automote/thingBot-LoRa/v1.1/REPORTS/thingBot-LoRa_v1P1_report.txt

Plot file 'P:\PCB Design\thingBot-LoRa\v1.1\GERBERS\thingBot-LoRa_v1P1-F.Cu.gbr' created.
Plot file 'P:\PCB Design\thingBot-LoRa\v1.1\GERBERS\thingBot-LoRa_v1P1-B.Cu.gbr' created.
Plot file 'P:\PCB Design\thingBot-LoRa\v1.1\GERBERS\thingBot-LoRa_v1P1-B.Paste.gbr' created.
Plot file 'P:\PCB Design\thingBot-LoRa\v1.1\GERBERS\thingBot-LoRa_v1P1-F.Paste.gbr' created.
Plot file 'P:\PCB Design\thingBot-LoRa\v1.1\GERBERS\thingBot-LoRa_v1P1-B.SilkS.gbr' created.
Plot file 'P:\PCB Design\thingBot-LoRa\v1.1\GERBERS\thingBot-LoRa_v1P1-F.SilkS.gbr' created.
Plot file 'P:\PCB Design\thingBot-LoRa\v1.1\GERBERS\thingBot-LoRa_v1P1-B.Mask.gbr' created.
Plot file 'P:\PCB Design\thingBot-LoRa\v1.1\GERBERS\thingBot-LoRa_v1P1-F.Mask.gbr' created.
Plot file 'P:\PCB Design\thingBot-LoRa\v1.1\GERBERS\thingBot-LoRa_v1P1-Dwgs.User.gbr' created.
Plot file 'P:\PCB Design\thingBot-LoRa\v1.1\GERBERS\thingBot-LoRa_v1P1-Edge.Cuts.gbr' created.
Plot file 'P:\PCB Design\thingBot-LoRa\v1.1\GERBERS\thingBot-LoRa_v1P1-Margin.gbr' created.
Plot file 'P:\PCB Design\thingBot-LoRa\v1.1\GERBERS\thingBot-LoRa_v1P1-B.Fab.gbr' created.
Plot file 'P:\PCB Design\thingBot-LoRa\v1.1\GERBERS\thingBot-LoRa_v1P1-F.Fab.gbr' created.
