automote/thingBot-LoRa/v1.1/thingBot-LoRa_v1P1.xlsx

thingBot-LoRa
BILL OF MATERIALS
Item | Quantity | Reference | Value | DESC | MFG_NAME | MPN | Package | Footprint | 1 | 100 | 500 | 1000 |  | 10 PCB | 100 PCB | 1000 PCB
1 | 1 | C1 | 15nF | CAPACITOR, CERAMIC X7R, 15nF, 50V, -10%/+10%, -55DEGC/+125DEGC, 0805, SMD | Murata | GRM219R71H153KA01D | 805 | Capacitors_SMD:C_0805_HandSoldering | 7 | 1.75 | 1.54 | 1.19 |  | 7 | 1.75 | 1.19
2 | 1 | C2 | 0.1uF | CAPACITOR, CERAMIC X7R, 0.1uF, 25V, -10%/+10%, -55DEGC/+125DEGC, 0805, SMD | Murata | GRM21BR71E104KA01L | 805 | Capacitors_SMD:C_0805_HandSoldering | 7 | 1.12 | 1.12 | 1.12 |  | 7 | 1.12 | 1.12
3 | 1 | D1 | Green POWER LED | LED, 2V, -55DEGC/+85DEGC, 0805, SMD | Lite-On | LTST-C171KGKT | 805 | LEDs:LED_0805 | 22.4 | 5.39 | 5.39 | 4.13 |  | 22.4 | 5.39 | 4.13
4 | 2 | R1 R2 | 1K | Current Sense Resistors - RESISTOR, 1K, -25%/+25% - 55DEGC/+125DEGC, 0805,SMD | Murata | BLM21AG102SN1D | 805 | Resistors_SMD:R_0805_HandSoldering | 7.7 | 2.8 | 2.8 | 2.59 |  | 15.4 | 5.6 | 5.18
5 | 1 | SW1 | RESET | TACTILE SWITCH, 50mA, 12VDC, -25dDEGC/+70DEGC, SMD | OMRON | B3U-1000P | B3U-1000P | Buttons_Switches_SMD:SW_SPST_B3U-1000P | 72.1 | 52.22 | 43.26 | 38.64 |  | 72.1 | 52.22 | 38.64
6 | 1 | U1 | EDGE_SMA | EDGE CONNECTOR, COAX RF, STRAIGHT, FEMALE, 1 PIN, SMD | Samtec | SMA-J-P-X-ST-EM1 |  | sma:EDGE_SMA_5 | 120 | 100 | 90 | 80 |  | 120 | 100 | 80
7 | 1 | U2 | RFM92/95 | Low Power Long Range Transceiver Module | ***** | ***** |  | Temp:RFM92_95_96_98 | 822.95 | 680.75 | 680.184 | 680 |  | 822.95 | 680.75 | 680
8 | 1 | U3 | XBEE_MODULE | XBee male plug | Harwin | M22-2510205 |  | Xbee:Xbee_mod | 13.3 | 6.37 | 6.37 | 5.6 |  | 13.3 | 6.37 | 5.6
9 | 1 | W1 | WIRE_ANT | wire antenna | ***** | ***** |  | Wire_Pads:SolderWirePad_single_2mmDrill | 0 | 0 | 0 | 0 |  | 0 | 0 | 0
10 | 2 | P7&p8 | Xbee_module_headers | 1x10 2mm male Header Through Hole | Harwin | M22-2510205 |  |  | 13.3 | 6.37 | 0 | 5.6 |  | 26.6 | 12.74 | 11.2
11 | 2 | R3 R4 | 0 ohm | Thin Film Resistors - SMD 0ohm 150V +/- 5% 0805, SMD | Yageo | AF0805JR-070RL | 805 | Resistors_SMD:R_0805_HandSoldering | 9.8 | 1.89 |  | 1.33 |  | 19.6 | 3.78 | 2.66
 |  |  |  |  |  |  |  |  |  |  |  |  | Total | 1126.35 | 869.72 | 829.72
