automote/thingBot-LoRa/v1.1/thingBot-LoRa_v1P1_BRD.pdf

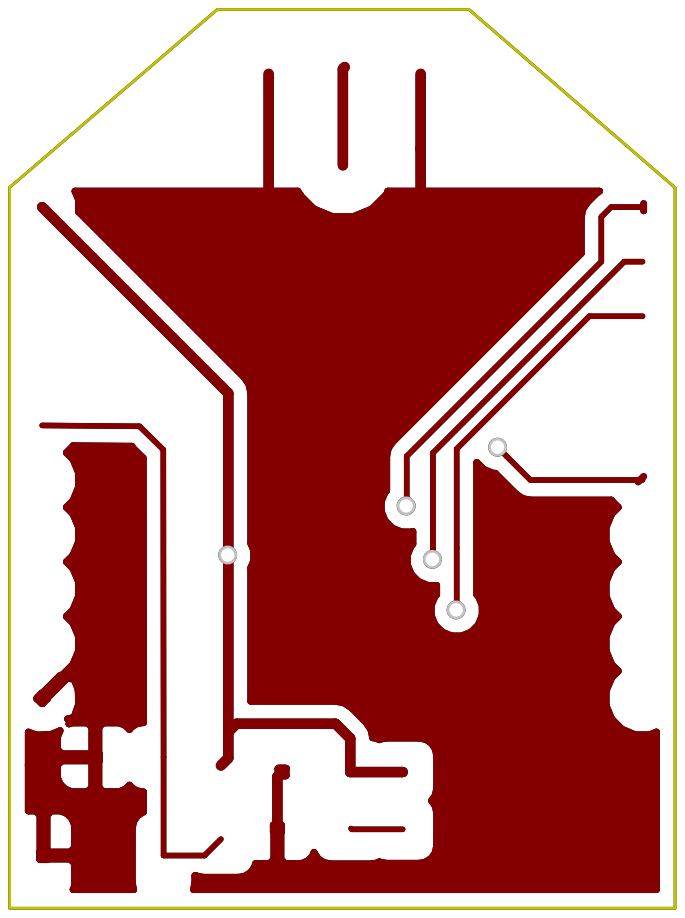
[picture p1: page 1]

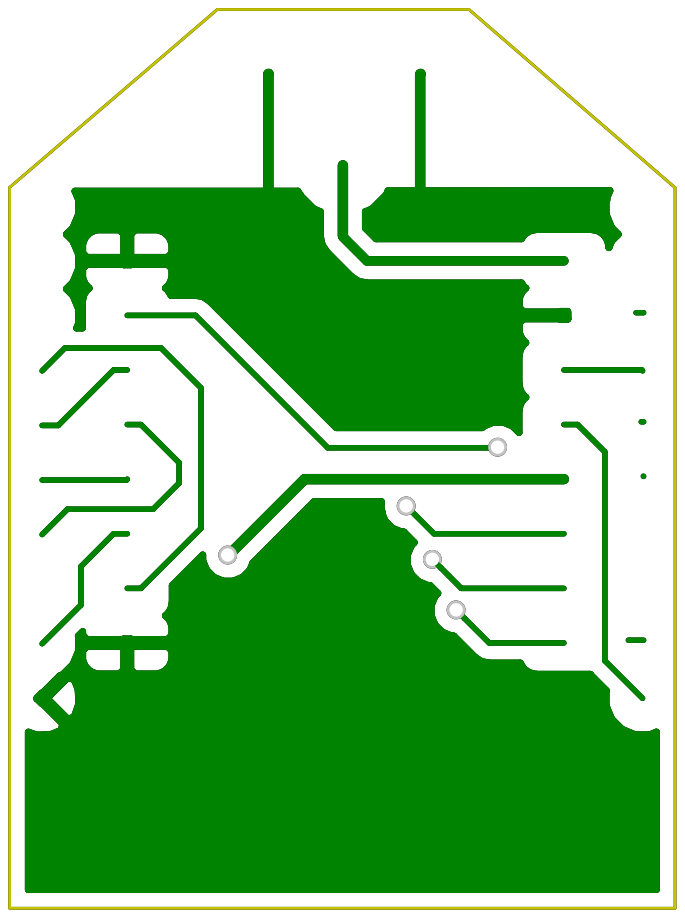
[picture p2: page 2]

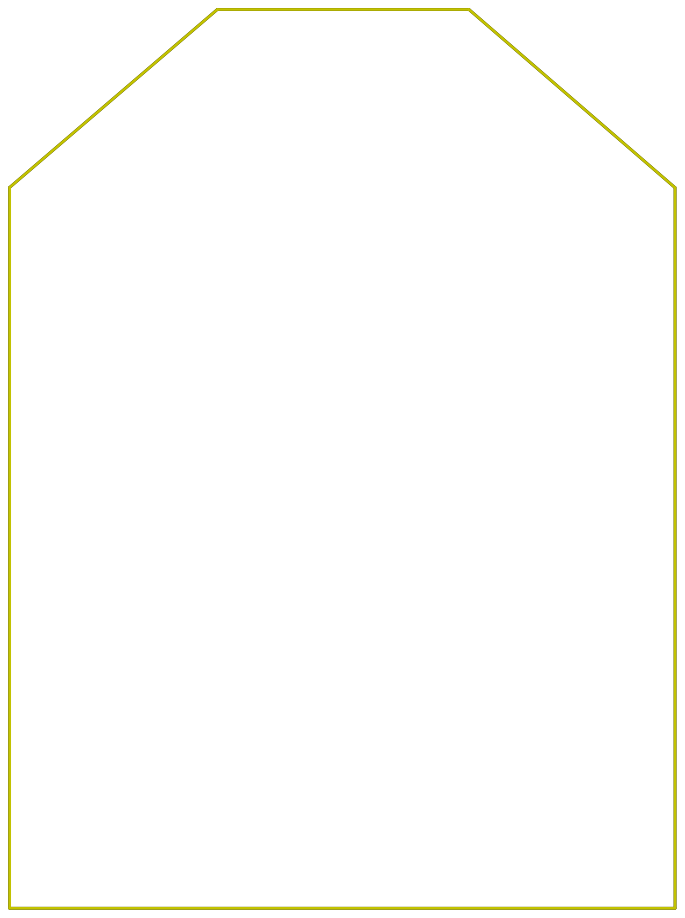
[picture p3: page 3]

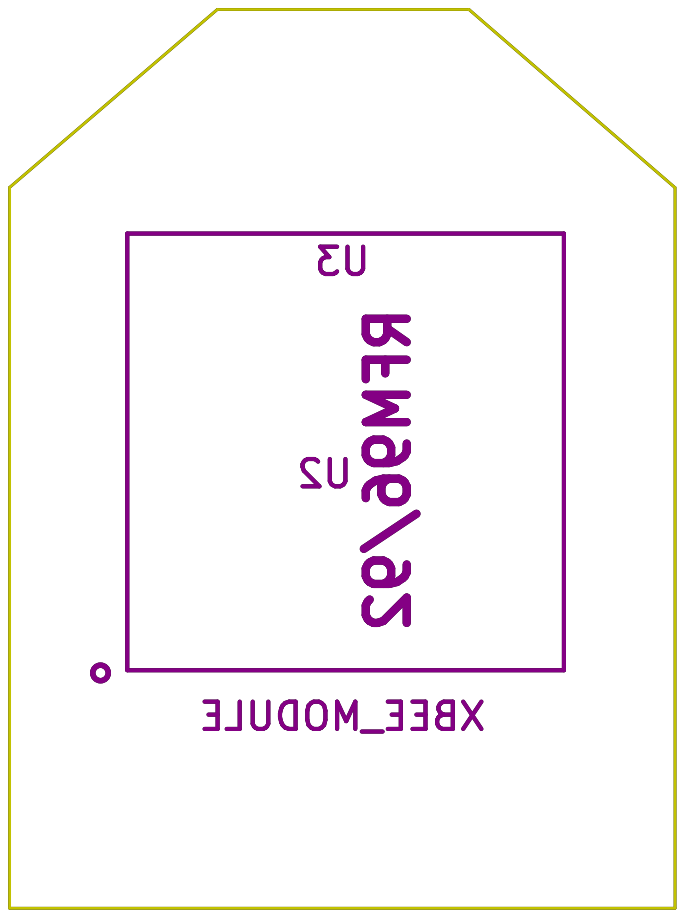
[picture p4: page 5]

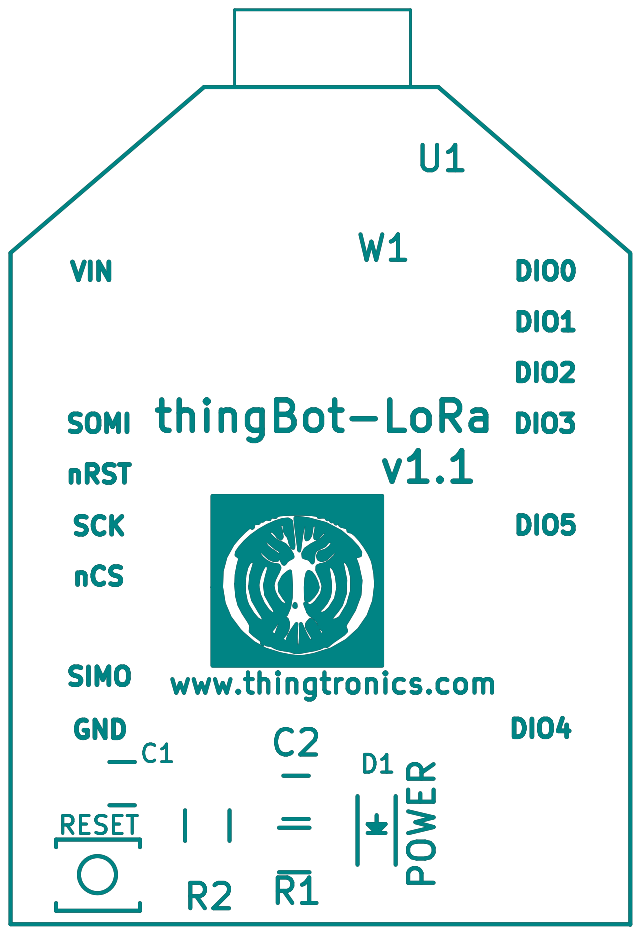
[picture p5: page 6]

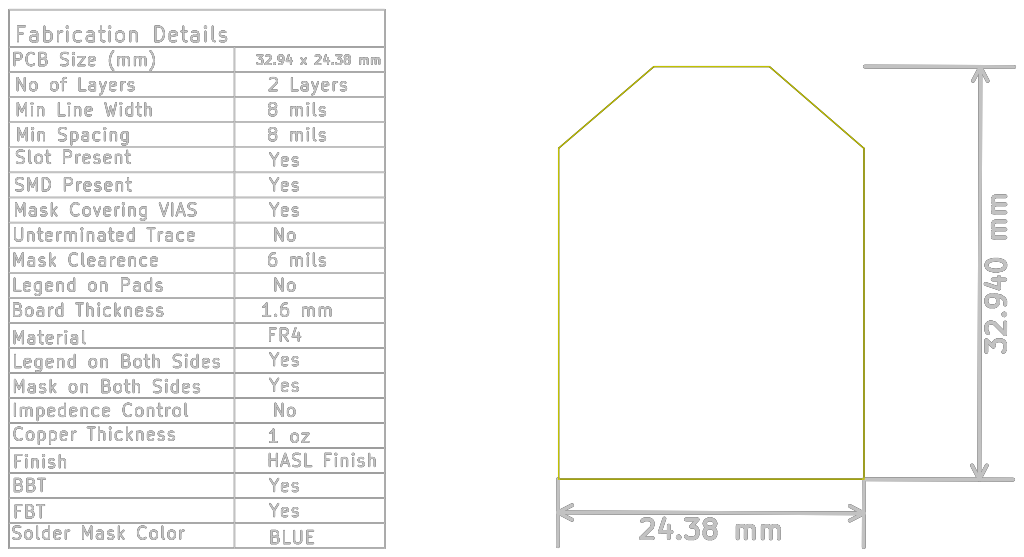
[picture p6: page 9]

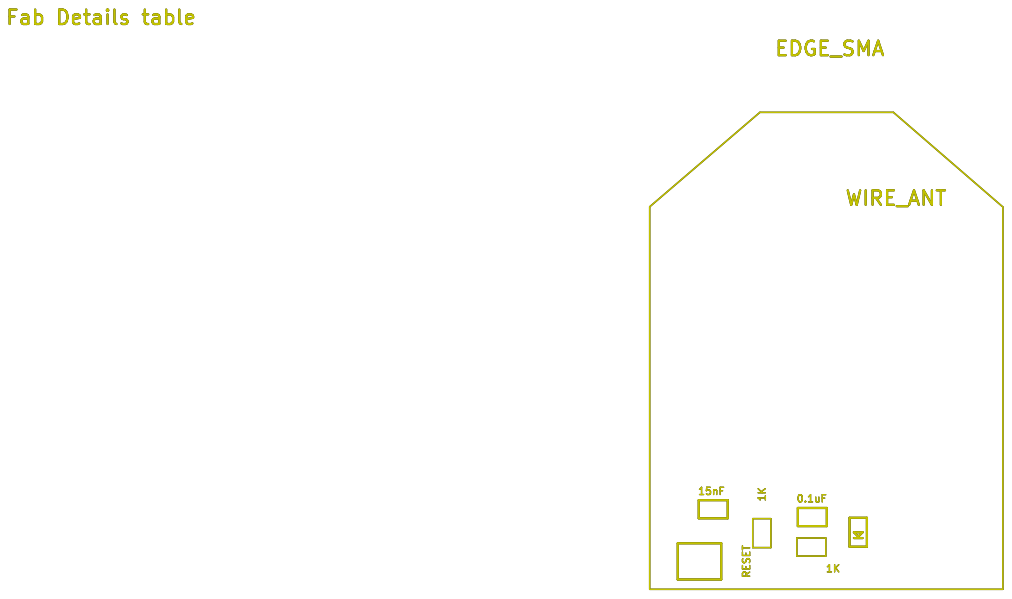
[picture p7: page 13]
