automote/thingBot-LoRa/v1.1/thingBot-LoRa_v1P1_SCH.pdf

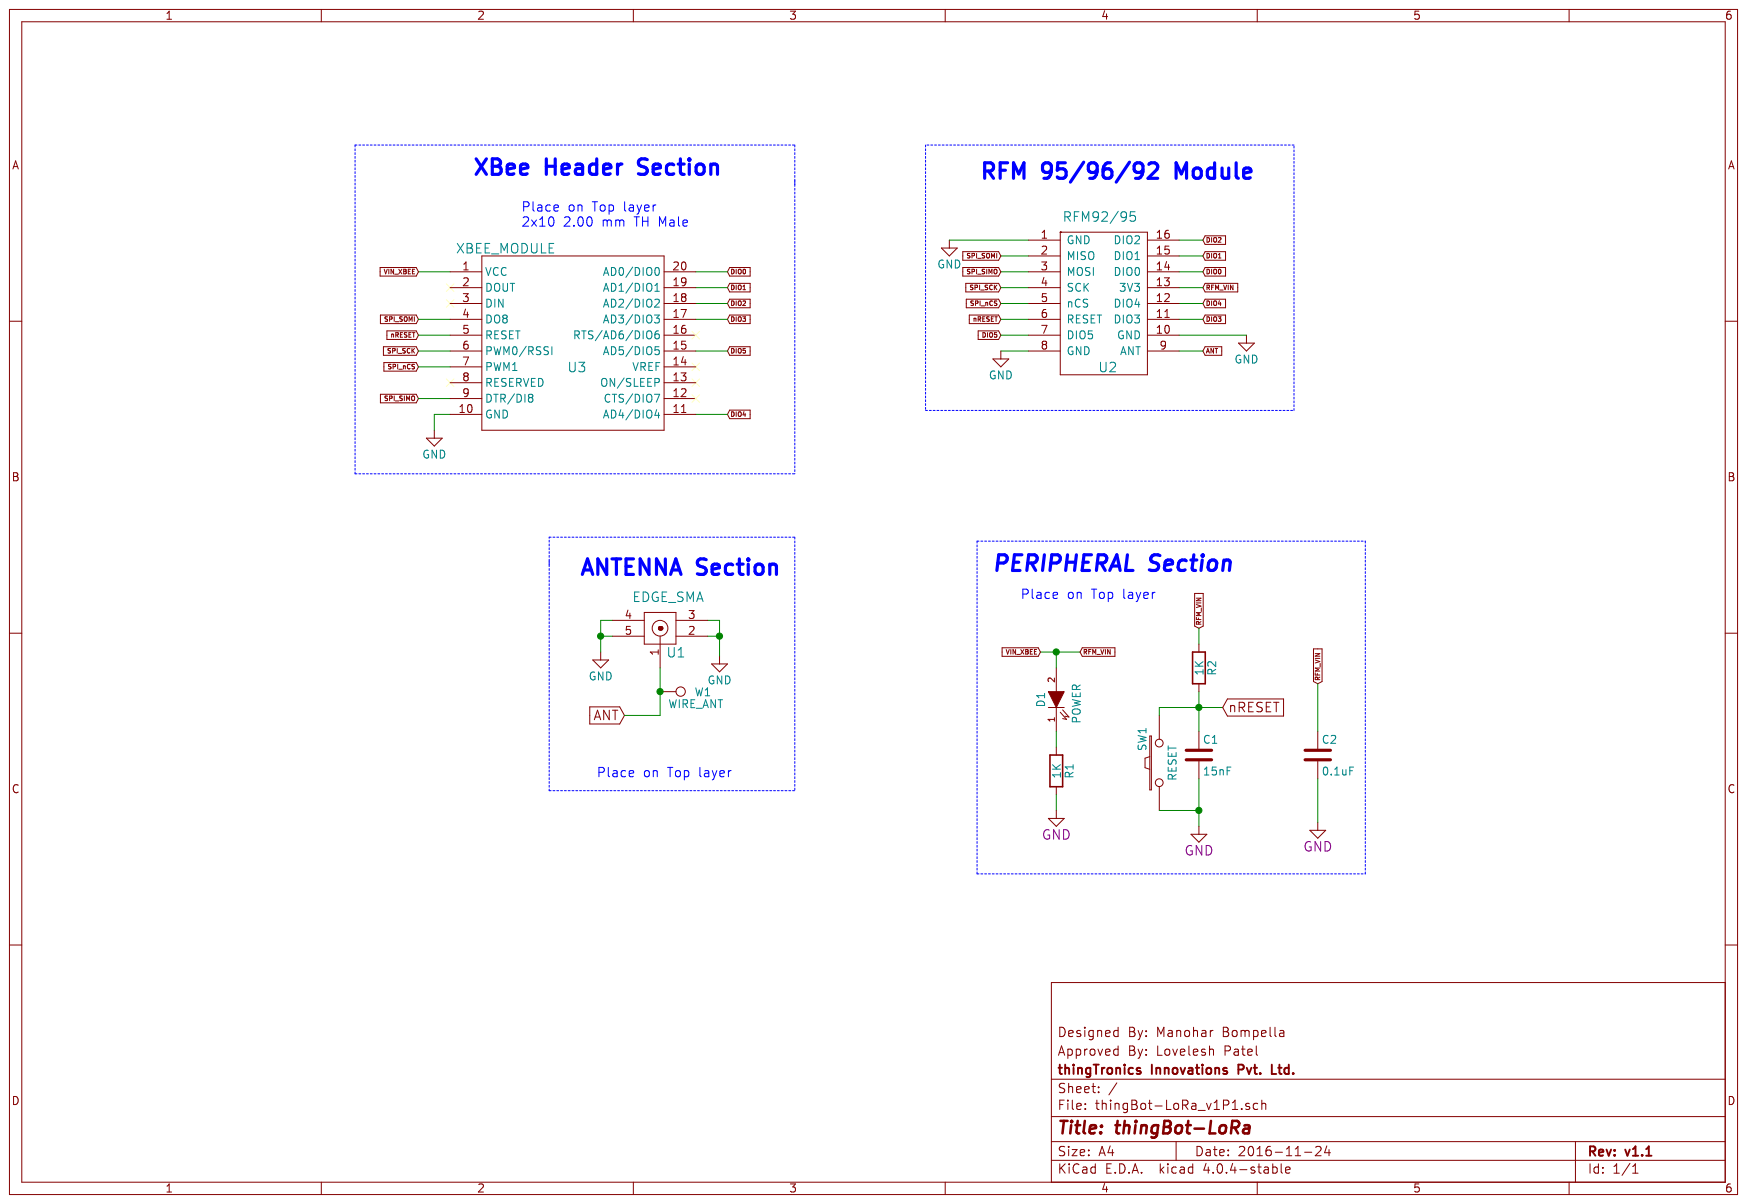
[picture p8: page 1]
