automote/thingBot-LoRa/(commit log)

2016-11-24 RFM96 Base Board schematic added
    [RFM96_95_92_BEE_BOARD.kicad_pcb, RFM96_95_92_BEE_BOARD.sch]
2016-11-24 created library files and changed schematic
    [RFM96_95_92_BEE_BOARD.sch]
2016-11-24 reviewed the design; modified library; made directory for v1.0
    Design verified and modification made
    library part edited
    power section added
    directory structure created
    [RFM96_95_92_BEE_BOARD.sch, thingBot-LoRa_v1P0.kicad_pcb, thingBot-LoRa_v1P0.sch]
2016-11-24 removed antenna library
2016-11-25 edited README; added power supply datasheet
2016-11-25 Added pheriperal section and power led ,changed in power section in schematic
    Power section LDO replaced with TPS63051 instead of TPS782,
    Power Led also included in Power Section,
    RESET Push button Added in Pheriperal Section.
    [thingBot-LoRa_v1P0.sch]
2016-11-26 removed power supply from README
2016-11-26 Power Section Removed, RFM96/92 library changed
    power section removed except power led,
    RFM96/92 library pins changed.
    [thingBot-LoRa_v1P0.sch]
2016-11-26 removed tps63051 datasheet; edited schematic; ready for layout
    [thingBot-LoRa_v1P0.sch]
2016-11-27 Added libraries
    Added Libraries
    [thingBot-LoRa_v1P0.sch]
2016-11-27 Updated README; updated schematic
    [thingBot-LoRa_v1P0.sch]
2016-11-28 libraries changed, Reference files added
    -Libraries MFG_NAME, MPN, DESC added
    -reference files added
    [thingBot-LoRa_v1P0.sch]
2016-11-28 removed library folder and made changes to part desc
    [thingBot-LoRa_v1P0.sch]
2016-11-28 annotated the schematic
    [thingBot-LoRa_v1P0.sch]
2016-12-01 Net list generated and footprint selected
    [LoRa.kicad_pcb, thingBot-LoRa_v1P0.kicad_pcb, thingBot-LoRa_v1P0.sch]
2016-12-30 final Layout and Gerber creation done
    [LoRa.kicad_pcb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]
2017-01-02 Final layout done and Gerbers generated
    [thingBot-LoRa_v1P0-B.Adhes.gbr, thingBot-LoRa_v1P0-B.Cu.gbr, thingBot-LoRa_v1P0-B.Fab.gbr, thingBot-LoRa_v1P0-B.Mask.gbr, thingBot-LoRa_v1P0-B.Paste.gbr, thingBot-LoRa_v1P0-B.SilkS.gbr, thingBot-LoRa_v1P0-Dwgs.User.gbr, thingBot-LoRa_v1P0-Edge.Cuts.gbr]
2017-01-02 verified design
    [thingBot-LoRa_v1P0.kicad_pcb, thingBot-LoRa_v1P0.sch]
2017-01-02 updated schematic pdf; made zip for GERBERs
2017-01-03 Solder Mask changed to blue
    [thingBot-LoRa_v1P0-B.Adhes.gbr, thingBot-LoRa_v1P0-B.Cu.gbr, thingBot-LoRa_v1P0-B.Fab.gbr, thingBot-LoRa_v1P0-B.Mask.gbr, thingBot-LoRa_v1P0-B.Paste.gbr, thingBot-LoRa_v1P0-B.SilkS.gbr, thingBot-LoRa_v1P0-Dwgs.User.gbr, thingBot-LoRa_v1P0-Edge.Cuts.gbr]
2017-01-28 v1.1 verified and uploaded
    - modified the SPST RESET button footprint
    - increased the font size of website to more readable format
    - added POWER name to D1 in F. Silk
    - bumped up the version to 1.1
    [thingBot-LoRa_v1P1-B.Cu.gbr, thingBot-LoRa_v1P1-B.Fab.gbr, thingBot-LoRa_v1P1-B.Mask.gbr, thingBot-LoRa_v1P1-B.Paste.gbr, thingBot-LoRa_v1P1-B.SilkS.gbr, thingBot-LoRa_v1P1-Dwgs.User.gbr, thingBot-LoRa_v1P1-Edge.Cuts.gbr, thingBot-LoRa_v1P1-F.Cu.gbr]
2017-01-28 Made changes to Top and Bot silk and changes the via positions
    [thingBot-LoRa_v1P1-B.Cu.gbr, thingBot-LoRa_v1P1-B.Fab.gbr, thingBot-LoRa_v1P1-B.Mask.gbr, thingBot-LoRa_v1P1-B.Paste.gbr, thingBot-LoRa_v1P1-B.SilkS.gbr, thingBot-LoRa_v1P1-Dwgs.User.gbr, thingBot-LoRa_v1P1-Edge.Cuts.gbr, thingBot-LoRa_v1P1-F.Cu.gbr]
2017-03-08 modified F silk and added pdf for SCH and BRD
    [thingBot-LoRa_v1P1.kicad_pcb, thingBot-LoRa_v1P1.sch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]
